adafruit/Adafruit-CC3000-Breakout-PCB/Adafruit CC3000 Breakout.brd

## EAGLE design Adafruit CC3000 Breakout.brd (2014-03-07)

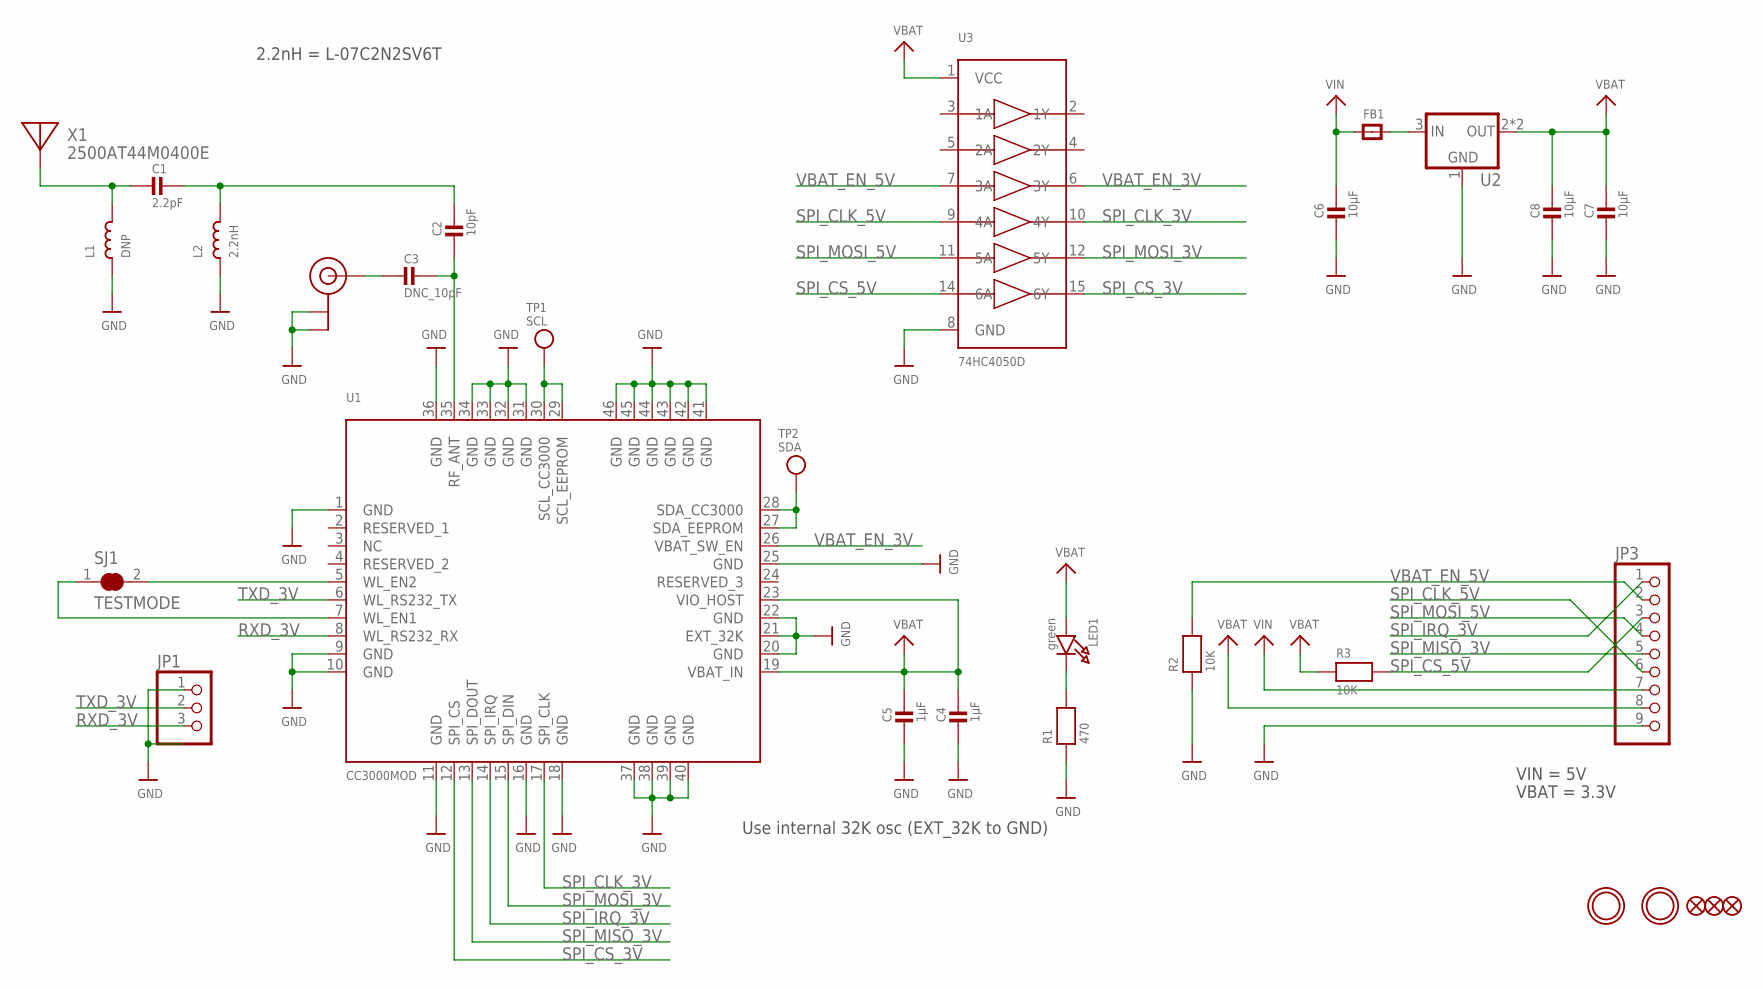
[picture p2: schematic Adafruit CC3000 Breakout.sch]

Parts:
C1: 2.2pF; _0402
C2: 10pF; _0402
C3: DNC_10pF; _0402
C4, C5: 1µF; _0805MP
C6, C7, C8: 10µF; _0805MP
FB1: FERRITE_0805MP; _0805MP
FID1, FID2, FID3: FIDUCIAL""; FIDUCIAL_1MM
JP1: HEADER-1X3ROUND; 1X03_ROUND
JP3: HEADER-1X970MIL; 1X09_ROUND_70
L1: DNP; _0402
L2: 2.2nH; _0402
LED1: green; CHIPLED_0805_NOOUTLINE
R1: 470; 0805-NO
R2, R3: 10K; _0805MP
SJ1: TESTMODE; SOLDERJUMPER_CLOSEDWIRE
TP1: SCL; TESTPOINT_PAD_1MM
TP2: SDA; TESTPOINT_PAD_1MM
U1: CC3000MOD
U2: VREG_SOT223; SOT223-R
U3: 74HC4050D; SOIC16
U$24, U$34: MOUNTINGHOLE2.5; MOUNTINGHOLE_2.5_PLATED
U$35: U.FL
X1: 2500AT44M0400E; ANT_2500AT44M0400

Connections:
GND: C4.2, C5.2, C6.2, C7.2, C8.2, JP1.1, JP3.9, L1.1, L2.1, R1.1, R2.1, U1.1 (GND), U1.9 (GND), U1.10 (GND), U1.11 (GND), U1.16 (GND), U1.18 (GND), U1.20 (GND), U1.21 (EXT_32K), U1.22 (GND), U1.25 (GND), U1.31 (GND), U1.32 (GND), U1.33 (GND), U1.34 (GND), U1.36 (GND), U1.37 (GND), U1.38 (GND), U1.39 (GND), U1.40 (GND), U1.41 (GND), U1.42 (GND), U1.43 (GND), U1.44 (GND), U1.45 (GND), U1.46 (GND), U2.1 (GND), U3.8 (GND), U$35.P$1 (GND), U$35.P$2 (GND)
unnamed: C1.2, L1.2, X1.FEED
unnamed: C1.1, C2.1, L2.2
unnamed: C3.2, U$35.P$3 (SIGNAL)
unnamed: C2.2, C3.1, U1.35 (RF_ANT)
unnamed: SJ1.2, U1.5 (WL_EN2)
unnamed: SJ1.1, U1.7 (WL_EN1)
unnamed: LED1.C, R1.2
unnamed: FB1.2, U2.3 (IN)
RXD_3V: JP1.3, U1.8 (WL_RS232_RX)
SCL_3V: TP1.P$1, U1.29 (SCL_EEPROM), U1.30 (SCL_CC3000)
SDA_3V: TP2.P$1, U1.27 (SDA_EEPROM), U1.28 (SDA_CC3000)
SPI_CLK_3V: U1.17 (SPI_CLK), U3.10 (4Y)
SPI_CLK_5V: JP3.6, U3.9 (4A)
SPI_CS_3V: U1.12 (SPI_CS), U3.15 (6Y)
SPI_CS_5V: JP3.3, R3.2, U3.14 (6A)
SPI_IRQ_3V: JP3.1, U1.14 (SPI_IRQ)
SPI_MISO_3V: JP3.5, U1.13 (SPI_DOUT)
SPI_MOSI_3V: U1.15 (SPI_DIN), U3.12 (5Y)
SPI_MOSI_5V: JP3.4, U3.11 (5A)
TXD_3V: JP1.2, U1.6 (WL_RS232_TX)
VBAT: C4.1, C5.1, C7.1, C8.1, JP3.8, LED1.A, R3.1, U1.19 (VBAT_IN), U1.23 (VIO_HOST), U2.2 (OUT), U2.4 (OUT), U3.1 (VCC)
VBAT_EN_3V: U1.26 (VBAT_SW_EN), U3.6 (3Y)
VBAT_EN_5V: JP3.2, R2.2, U3.7 (3A)
VIN: C6.1, FB1.1, JP3.7

Notes on the sheet:
Use internal 32K osc (EXT_32K to GND)
VIN = 5V
VBAT = 3.3V
2.2nH = L-07C2N2SV6T

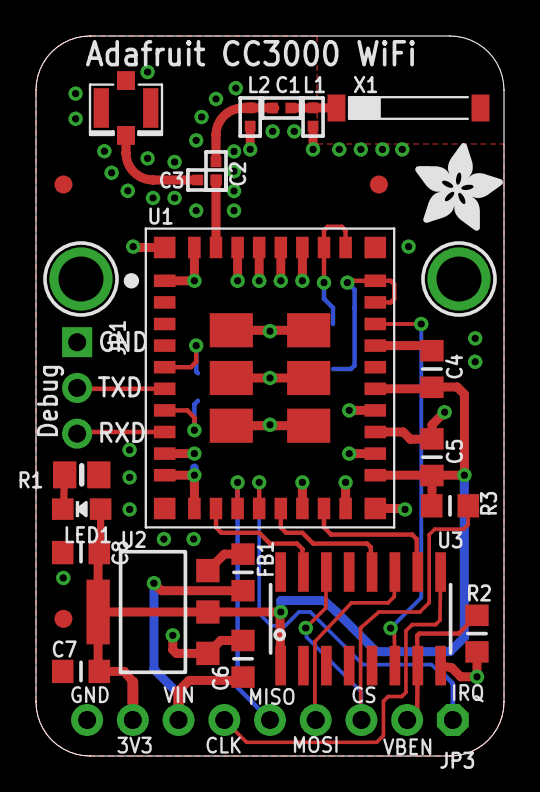
[picture p3: board Adafruit CC3000 Breakout.brd from above]

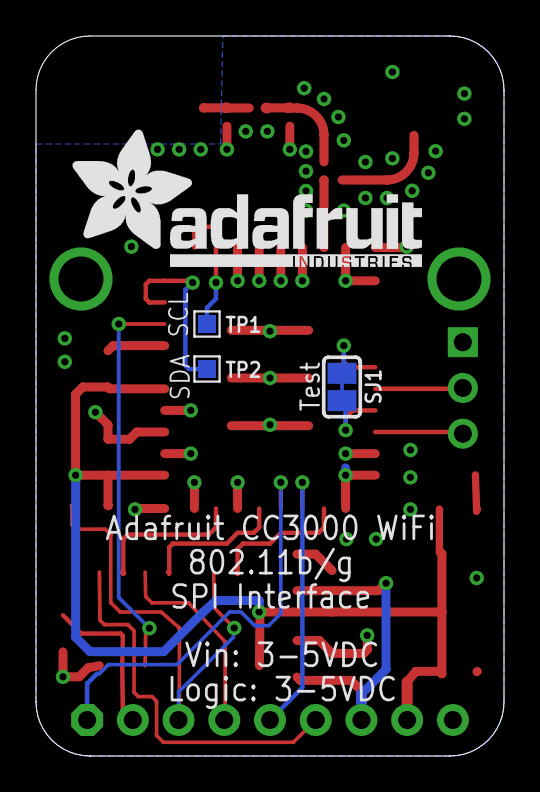
[picture p4: board Adafruit CC3000 Breakout.brd from below]

Board: 2 copper layers, 26.0 x 40.0 mm, 32 parts (4 on the bottom side), 25 nets.

Other parts of the board:
U$8: ADAFRUIT_5MM
U$36: ADAFRUIT_TEXT_20MM
